lowestofthe1ow/cemicro-mp/(commit log)

2025-11-18 KiCad schematics
    [cemicro-mp.kicad_pcb, cemicro-mp.kicad_sch, cemicro-mp_expanded.kicad_sch]
2025-11-19 Fix reading from SCSR / Remove termination resistors from schematic
    [cemicro-mp.kicad_sch]
2025-11-19 Fixes to Python script/ASM, control CE' and OE' with PORTA
    [main.asm]
2025-11-19 Update schematic for PORTA connection
    [cemicro-mp.kicad_sch]
2025-11-19 Prepare for Part II / Save current schematic as _read.kicad_sch
    [EPROM_Prog_PS.kicad_pcb, EPROM_Prog_PS.kicad_sch, cemicro-mp_read.kicad_sch]
2025-11-30 Kicad PCB
    [EPROM_Prog_Assembled.kicad_pcb]
2025-12-01 Fixes to pulse test
    [main.asm]
2025-12-04 Codebase cleanup + ASM program
    [EPROM_Prog_Assembled.kicad_pcb, EPROM_Prog_PS.kicad_pcb, EPROM_Prog_PS.kicad_sch, cemicro-mp.kicad_pcb, cemicro-mp.kicad_sch, cemicro-mp_expanded.kicad_sch]
2025-12-04 KiCad update
    [cemicro-mp.kicad_sch, cemicro-mp_read.kicad_sch]
2025-12-05 Perform final check + fix PACTL write
    [program.asm]
2025-12-05 Final Python script + fixes to read.asm
    [HC11_2764_programmer.py, program.asm, read.asm]
2025-12-05 one-sided pcb
    [EPROM_Prog_PS.kicad_pcb]
